rminsley/s30_electronics_jiang_minsley/Circuit_diagram_1.jpg

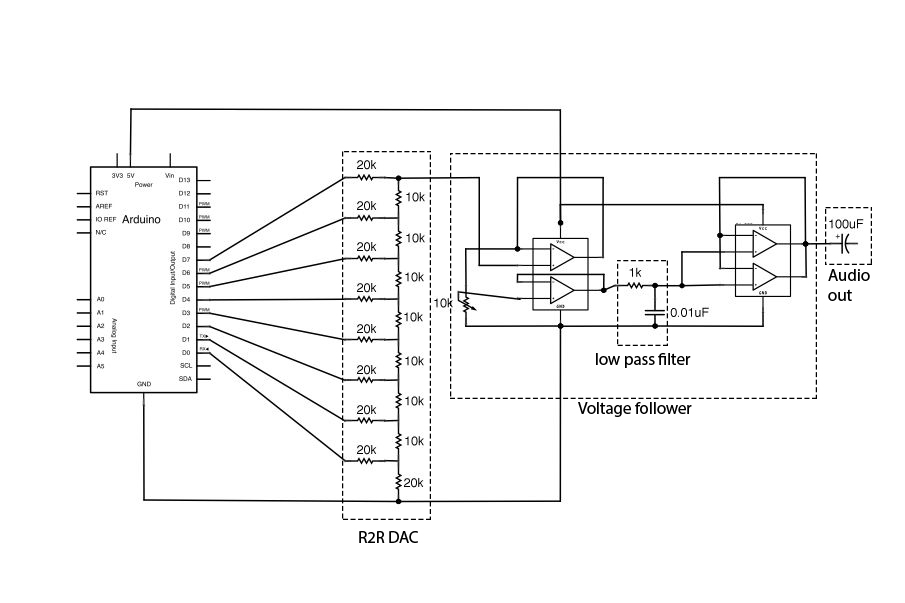
Circuit_diagram_1.jpg
