rminsley/s30_electronics_jiang_minsley/Circuit_diagram_2.jpg

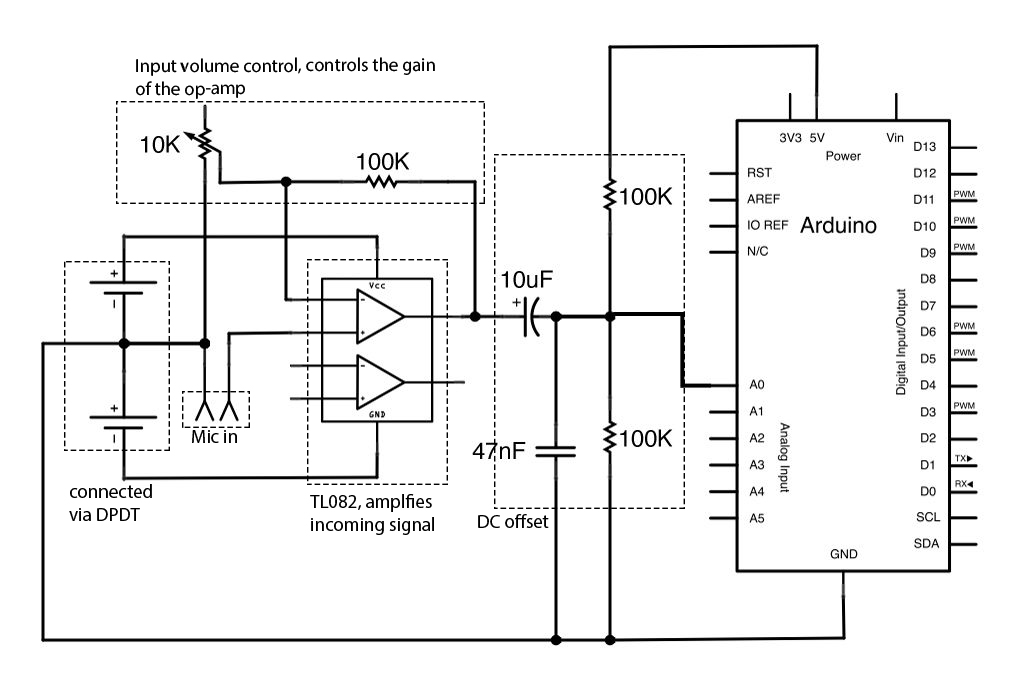
Circuit_diagram_2.jpg
