rminsley/s30_electronics_jiang_minsley/Circuit_diagram_3.jpg

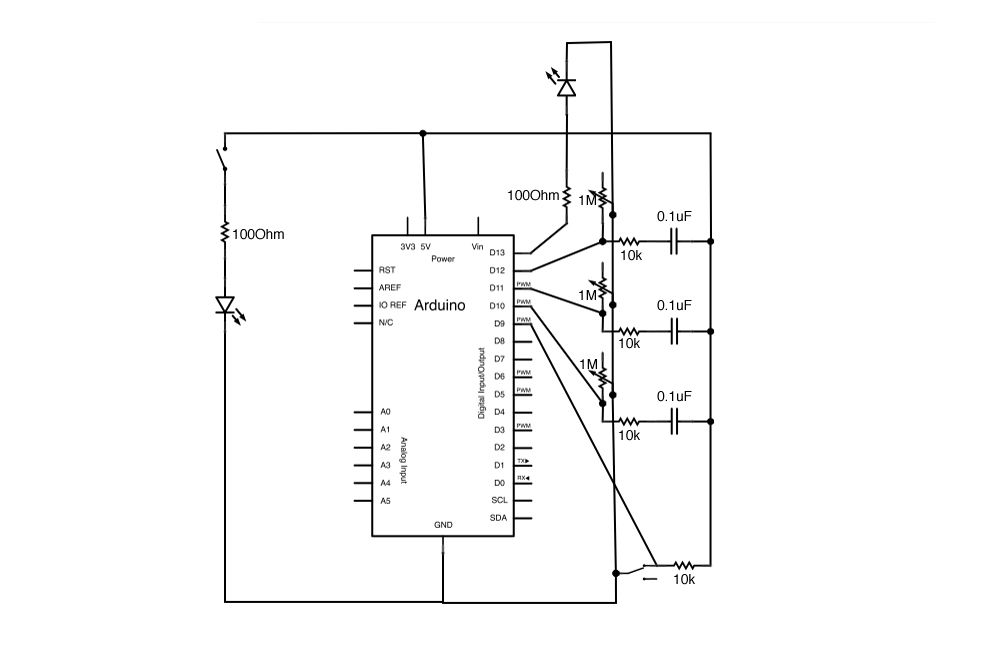
Circuit_diagram_3.jpg
